roy-rishi/lithophane-lightbox/render/labels/base.png

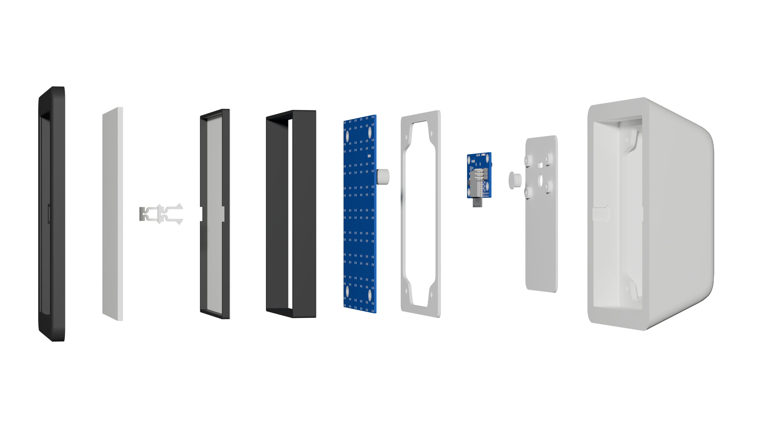
render/labels/base.png
