roy-rishi/lithophane-lightbox/ecad/led-panel/fab-v1/led-panel-bom.csv

Reference | Quantity | Value | Exclude from BOM | Footprint | Manufacture Part Number | LCSC Part Number
D1,D2,D3,D4,D5,D6,D7,D8,D9,D10,D11,D12,D13,D14,D15,D16,D17,D18,D19,D20,D21,D22,D23,D24,D25,D26,D27,D28,D29,D30,D31,D32,D33,D34,D35,D36,D37,D38,D39,D40,D41,D42,D43,D44,D45,D46,D47,D48,D49,D50,D51,D52,D53,D54 | 54 | WS2812B |  | LED_SMD:LED_WS2812B_PLCC4_5.0x5.0mm_P3.2mm | WS2812B-V5/W | C2874885
J1 | 1 | Conn_01x03 |  | Connector_JST:JST_XH_B3B-XH-AM_1x03_P2.50mm_Vertical | B3B-XH-A(LF)(SN) | C144394
C1 | 1 | 1000uF |  | Capacitor_SMD:C_Elec_10x10.2 | RVT1C102M1010 | C72470
