roy-rishi/lithophane-lightbox/ecad/controller/fab-v1/controller.step

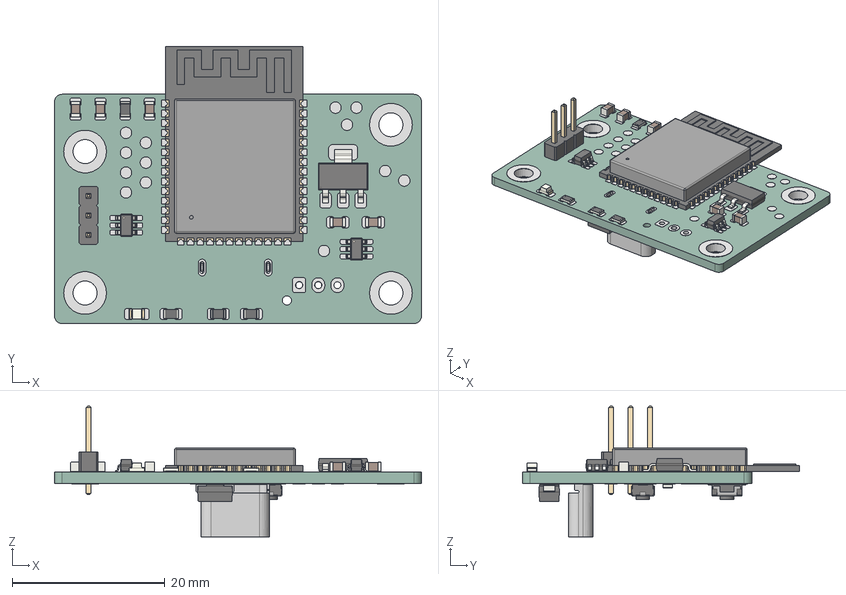
[picture p2: CAD file, 2026-08-24]
ecad/controller/fab-v1/controller.step
48.0 x 36.2 x 17.1 mm
R_0805_2012Metric x 6
SOT-223
SOT-23-6 x 2
C_0805_2012Metric x 6
LED_0805_2012Metric
ESP32-S3-WROOM-1
PinHeader_1x03_P254mm_Vertical
SW_SPST_TS-1088-xR020 x 3
D_SMA
usb-c-vertical
controller-unsaved-export-ZFk9O2_pad
controller-unsaved-export-ZFk9O2_PCB
