roy-rishi/lithophane-lightbox/ecad/led-panel/fab-v1/lightbox.step

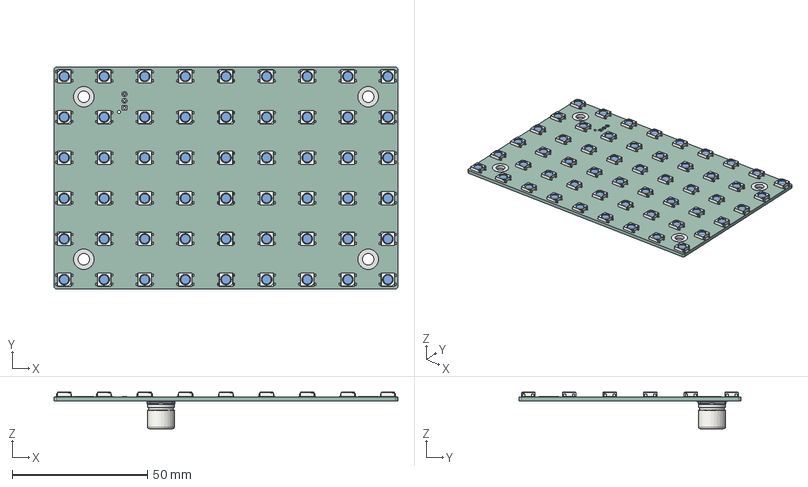
[picture p3: CAD file, 2026-08-24]
ecad/led-panel/fab-v1/lightbox.step
127.0 x 82.0 x 13.5 mm
LED_WS2812B_PLCC4_50x50mm_P32mm x 54
C_Elec_10x102
lightbox_pad
lightbox_PCB
