roy-rishi/lithophane-lightbox/(list of files, cad)

Other CAD files:
render/exploded-view.blend
