roy-rishi/lithophane-lightbox/ecad/controller/controller.kicad_pcb

## KiCad design ecad/controller/controller.kicad_pcb (2026-09-06)

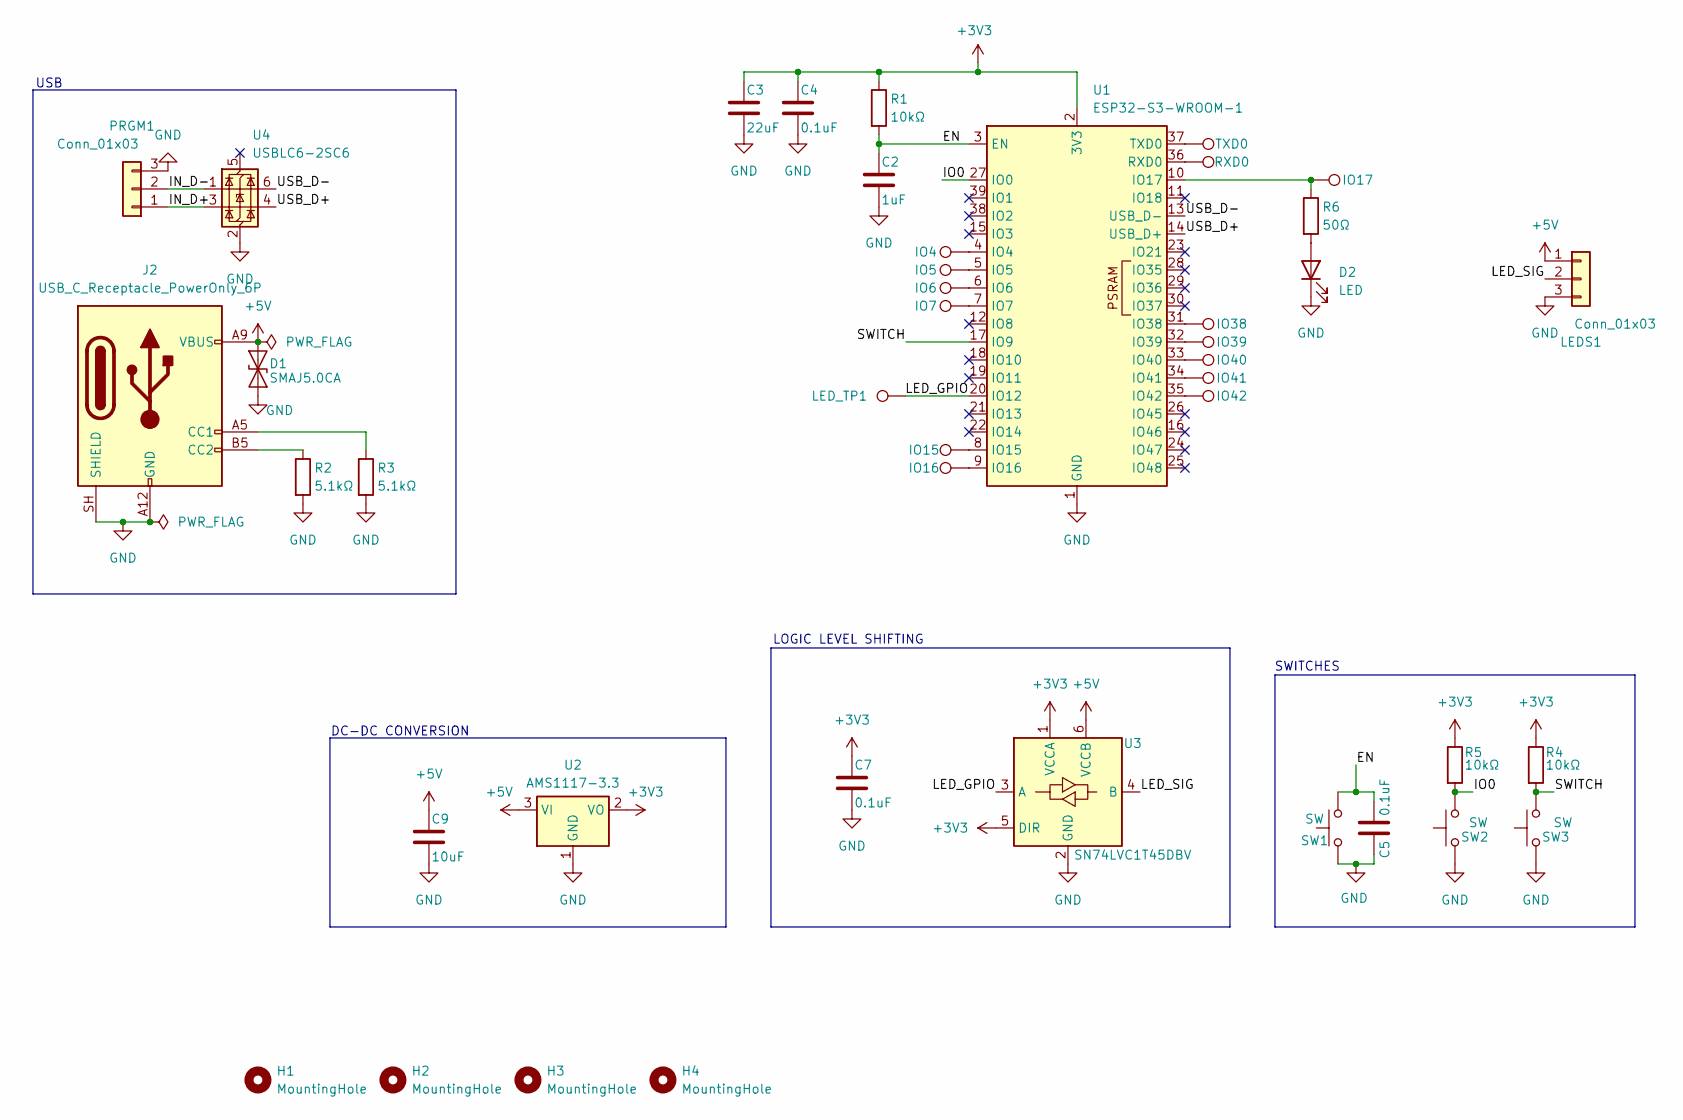
[picture p4: schematic controller.kicad_sch]

Parts:
C2: 1uF; C_0805_2012Metric; MPN CL21B105KBFNNNE; LCSC# C28323
C3: 22uF; C_0805_2012Metric; MPN GRM21BR61E226ME44L; LCSC# C86816
C4, C5, C7: 0.1uF; C_0805_2012Metric; MPN CL21B104KBCNNNC; LCSC# C1711
C9: 10uF; C_0805_2012Metric; MPN CL21A106KAYNNNE; LCSC# C15850
D1: SMAJ5.0CA; D_SMA; MPN SMAJ5.0CA; LCSC# C83324
D2: LED; LED_0805_2012Metric_Pad1.15x1.40mm_HandSolder; MPN XL-2012SURC; LCSC# C965812
H1, H2, H3, H4: MountingHole; MountingHole_3.2mm_M3_DIN965_Pad_TopOnly
IO4, IO5, IO6, IO7, IO15, IO16, IO17, IO38, IO39, IO40, IO41, IO42: TestPoint; TestPoint_Pad_D1.5mm
J2: USB_C_Receptacle_PowerOnly_6P; usb-c-vertical-smd; MPN TYPE-C 6PLTH6.8-DJ; LCSC# C5156600
LEDS1: Conn_01x03; JST_XH_B3B-XH-AM_1x03_P2.50mm_Vertical; MPN B3B-XH-A(LF)(SN); LCSC# C144394
LED_TP1: TestPoint; TestPoint_Pad_D1.5mm
PRGM1: Conn_01x03; PinHeader_1x03_P2.54mm_Vertical; MPN HX PH254-01-03-Z-L11.5 pcb pin header; LCSC# C52016391
R1, R4, R5: 10kΩ; R_0805_2012Metric; MPN FRC0805F1002TS; LCSC# C2907219
R2, R3: 5.1kΩ; R_0805_2012Metric; MPN RC0805FR-075K1L; LCSC# C84375
R6: 50Ω; R_0805_2012Metric; MPN ARG05FTC0500; LCSC# C2828866
RXD0: TestPoint; TestPoint_Pad_D1.5mm
SW1, SW2, SW3: SW; SW_SPST_TS-1088-xR020; MPN TS-1088-AR02016; LCSC# C720477
TXD0: TestPoint; TestPoint_Pad_D1.5mm
U1: ESP32-S3-WROOM-1; MPN ESP32-S3-WROOM-1-N16R8; LCSC# C2913202
U2: AMS1117-3.3; SOT-223-3_TabPin2; MPN AMS1117-3.3; LCSC# C6186
U3: SN74LVC1T45DBV; SOT-23-6_Handsoldering; MPN SN74LVC1T45DBVR; LCSC# C7843
U4: USBLC6-2SC6; SOT-23-6_Handsoldering; MPN USBLC6-2SC6; LCSC# C7519

Connections:
+3V3: C3.1, C4.1, C7.1, R1.1, R4.1, R5.1, U1.2 (3V3), U2.2 (VO), U3.1 (VCCA), U3.5 (DIR)
+5V: C9.1, D1.2 (A2), J2.A9 (VBUS), J2.B9 (VBUS), LEDS1.1, U2.3 (VI), U3.6 (VCCB)
/EN: C2.1, C5.1, R1.2, SW1.2, U1.3 (EN)
/IN_D+: PRGM1.1, U4.3 (I/O2)
/IN_D-: PRGM1.2, U4.1 (I/O1)
/IO0: R5.2, SW2.2, U1.27 (IO0)
/LED_GPIO: LED_TP1.1 (1_1), U1.20 (IO12), U3.3 (A)
/LED_SIG: LEDS1.2, U3.4 (B)
/SWITCH: R4.2, SW3.2, U1.17 (IO9)
/USB_D+: U1.14 (USB_D+), U4.4 (I/O2)
/USB_D-: U1.13 (USB_D-), U4.6 (I/O1)
GND: C2.2, C3.2, C4.2, C5.2, C7.2, C9.2, D1.1 (A1), D2.1 (K), J2.A12 (GND), J2.B12 (GND), J2.SH (SHIELD), LEDS1.3, PRGM1.3, R2.2, R3.2, SW1.1, SW2.1, SW3.1, U1.1 (GND), U1.40 (GND), U1.41 (GND), U2.1 (GND), U3.2 (GND), U4.2 (GND)
unnamed: D2.2 (A), R6.2
unnamed: J2.A5 (CC1), R3.1
unnamed: J2.B5 (CC2), R2.1
unnamed: IO4.1 (1_1), U1.4 (IO4)
unnamed: IO5.1 (1_1), U1.5 (IO5)
unnamed: IO6.1 (1_1), U1.6 (IO6)
unnamed: IO7.1 (1_1), U1.7 (IO7)
unnamed: IO15.1 (1_1), U1.8 (IO15)
unnamed: IO16.1 (1_1), U1.9 (IO16)
unnamed: IO17.1 (1_1), R6.1, U1.10 (IO17)
unnamed: IO38.1 (1_1), U1.31 (IO38)
unnamed: IO39.1 (1_1), U1.32 (IO39)
unnamed: IO40.1 (1_1), U1.33 (IO40)
unnamed: IO41.1 (1_1), U1.34 (IO41)
unnamed: IO42.1 (1_1), U1.35 (IO42)
unnamed: RXD0.1 (1_1), U1.36 (RXD0)
unnamed: TXD0.1 (1_1), U1.37 (TXD0)

Notes on the sheet:
SWITCHES
DC-DC CONVERSION
USB
LOGIC LEVEL SHIFTING

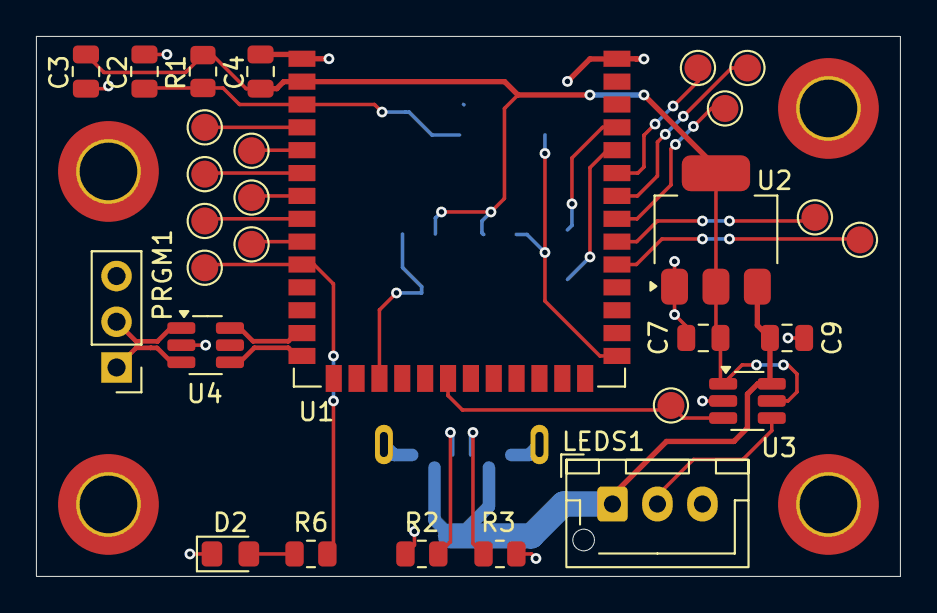
[picture p5: board controller.kicad_pcb from above]

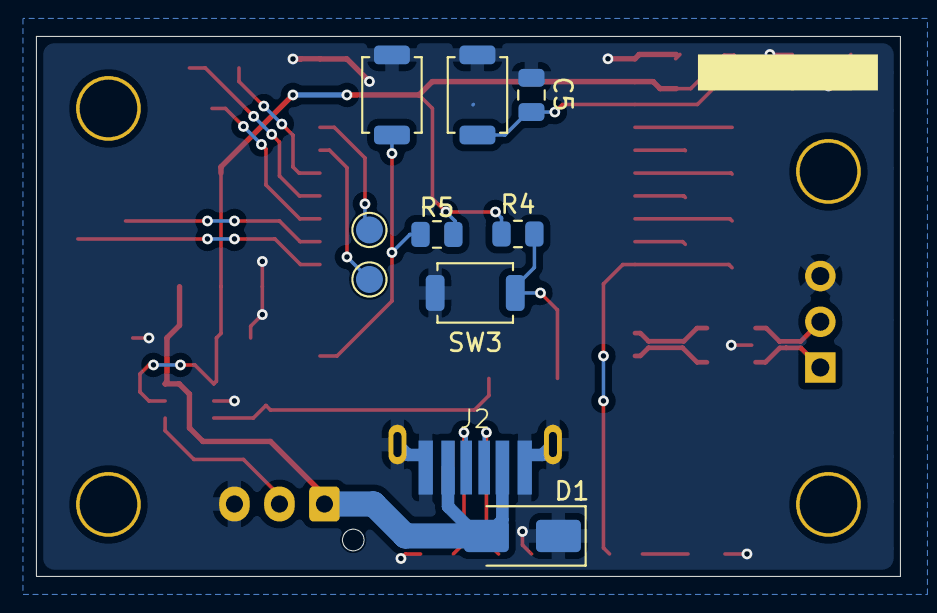
[picture p6: board controller.kicad_pcb from below]

Board: 2 copper layers, 48.0 x 30.0 mm, 43 parts (10 on the bottom side), 29 nets.
