roy-rishi/lithophane-lightbox/(commit log)

2026-08-07 arrange and route LEDs in grid on 4 layer PCB
    [led-row.kicad_sch, lightbox.kicad_pcb, lightbox.kicad_sch]
2026-08-07 ignore KiCad temp lck files
2026-08-10 switch to 2 layer, finish routing LEDs, add other controller components
    [controller.kicad_pcb, controller.kicad_sch, led-grid.kicad_sch, led-row.kicad_sch, lightbox.kicad_pcb, lightbox.kicad_sch]
2026-08-11 remove USB C port, using JST-XH connector to breakout board instead; add testpoints; switch from 2 gnd planes to 1 5V plane and 1 gnd plane; prelim routing complete
    [lightbox.kicad_pcb, lightbox.kicad_sch]
2026-08-11 before splitting into 2 boards
    [lightbox.kicad_pcb, lightbox.kicad_sch]
2026-08-11 split into 2 boards; switch led panel from 4 layers to 2 layers;
    [controller.kicad_pcb, controller.kicad_sch, lightbox.kicad_pcb, lightbox.kicad_sch]
2026-08-14 added vertical USB-C connector to controller board; and possibly much more
    [controller.kicad_pcb, controller.kicad_sch, controller.step, led-row.kicad_sch, lightbox.kicad_pcb, lightbox.kicad_sch]
2026-08-14 who knows
    [controller.kicad_pcb, controller.kicad_sch, controller.step]
2026-08-17 prelim checks of led panel
    [lightbox.kicad_pcb, lightbox.kicad_sch]
2026-08-18 add ESD protection; change USB connectors; ajust ESP32 pinout; more
    [controller.kicad_pcb, controller.kicad_sch]
2026-08-18 add decoupling caps; correct hole shape in usb-c footprint
    [controller.kicad_pcb, controller.kicad_sch]
2026-08-18 populate BOM fields with MPN and LCSC Part #
    [controller.kicad_sch, led-row.kicad_sch, lightbox.kicad_sch]
2026-08-19 model and link USB-C 3D connector
    [controller.kicad_pcb]
2026-08-19 final design review for v1 order; reroute some components; add LED to controller
    [controller.kicad_pcb, controller.kicad_sch, lightbox.kicad_pcb, lightbox.kicad_sch]
2026-08-19 v1 order fabrication files and BOMs
    [controller-B_Cu.gbl, controller-B_Mask.gbs, controller-B_Paste.gbp, controller-B_Silkscreen.gbo, controller-Edge_Cuts.gm1, controller-F_Cu.gtl, controller-F_Mask.gts, controller-F_Paste.gtp]
2026-08-19 update USB-C STEP file path
    [controller.kicad_pcb]
2026-08-19 update gitignore with KiCad template
    remove local project settings
2026-08-19 make paths relative and embed step
    [controller.kicad_pcb]
2026-08-24 3D STEP files for boards at v1 fab time
    [controller.step, lightbox.step]
2026-08-24 add new ESP32 empty project
2026-08-24 blink status led; configure build for top-level include and src files
2026-08-27 add addressable LED drivers and initialization; gamma correction
    [gen-gamma-table.py, main.c]
2026-08-27 add addressable led utils
2026-08-27 led panel turns on/off in response to BLE characteristic writes
2026-08-28 button component with debouncing
2026-09-06 switch target to ESP32-S3 and change pinout to match custom board
2026-09-06 first controller board test complete! updated USB-C connector footprint as that was the only issue found so far
    longer pads should make it easier to solder by giving the iron more clearance from the part; narrower shell mounting slots to reduce the sloppy fit and help alignment with 3D-printed casing
    [controller.kicad_pcb]
2026-09-24 config updates for final version; reduce brightness to 85% (70% power)
2026-09-24 add Blender project for animating an exploded view
    [exploded-view.blend]
2026-09-24 add labels that fade in at the end of animation; rename directory
    [exploded-view.blend]
